LUGRIOT/SmartBees/concentrateur-p4/docs/architecture/ruche-cca-v27-architecture.html

Branche RUCHE-CCA-V27.01 · spec rev 1.1

# Architecture Ruche CCA V27

Un rucher, un concentrateur. Les capteurs Zigbee et le nœud balance parlent au coordinateur XIAO ESP32-C6, qui reste allumé en permanence. L'ESP32-P4 se réveille toutes les 5 minutes, récupère tout, écoute la ruche, puis publie sur le cloud par LTE.

HIVE_ID cca-ruche-0001Zigbee 3.0 · canal 11–26MQTT mTLS :8883cycle 300 s

Vue système

## Qui parle à qui

câble radio trajet d'une pesée

Le réseau Zigbee ne dépend jamais de l'éveil du P4 : le coordinateur garde les reports en mémoire pendant que le P4 dort, puis les lui donne au réveil.

Couches logicielles

## Ce qui tourne sur chaque appareil

### Capteur T/H

appareil du commerce

Firmware fabricantMesure, pile, appairage par appui long

Clusters ZCL standard0x0402 température, 0x0405 humidité, 0x0001 batterie

Zigbee 3.0 · end devicePile CR2450 ou CR2477

à acheter

### Nœud balance

XIAO ESP32-C6 · Arduino

BalanceRuche.inoPesée (4 jetés, moyenne de 10), report à chaque réveil, écoute 5 s, mode réglage 180 s

Adafruit NAU7802I2C 0x2A, gain 128, 10 SPS, LDO 3,0 V, power-down entre deux pesées

Core esp32 3.3.8 · Zigbee ED6 endpoints : poids + 5 réglages, deep sleep

firmware écrit recette au banc Z2M à faire

### Coordinateur

XIAO ESP32-C6 · C

uart_proto · ble_portalLignes JSON vers le P4, file d'écritures vers le nœud balance, BLE avec passkey, impulsion de réveil

zb_interview · report_ring · dev_tableBasic, endpoints, bind, reporting ; anneau de 512 reports

esp-zigbee-lib + ZBOSS · ZCForme le réseau, permit join 1–254 s

spike S3, puis plan 2

### ESP32-P4-NANO

Rust · esp-idf-svc

ruche-fwCycle 5 min, UART C6, I2S, SD, PPP + MQTT, portail Wi-Fi

ruche-coreProtocole C6, converters ZCL façon Zigbee2MQTT, pont, audio, alarme, payloads

ESP-IDF 5.5 + composants Cesp_hosted, esp_modem, usb_host_cdc_acm

ruche-core fait · 41 tests ruche-fw : spikes S1 et S2, puis plan 3

Une mesure, de bout en bout

## Trajet d'une pesée jusqu'au cloud

Exemple réel de format à chaque étape. Le nœud balance pèse la ruche n°1 à 41,853 kg ; le P4 se réveille 122 secondes plus tard.

1. Nœud balancet = 0
  Réveil par son timer (toutes les 3600 s par défaut). 4 échantillons du NAU7802 jetés, moyenne de 10, offset et échelle appliqués. Il envoie le report, attend l'acquittement, écoute 5 s au cas où un réglage l'attend, puis se rendort.

cluster 0x000C Analog Input  attribut 0x0055 PresentValue
type    0x39 float simple     valeur   41.853
2. Coordinateur C6t = 0
  Reçoit le report et le range dans l'anneau avec un numéro de séquence. Rien ne part tant que le P4 ne le demande pas.

anneau[10201] = { ieee 0x00124b0012345678, ep 1, cl 0x000C, at 0x0055, v 41.853, lqi 176 }
3. P4 → C6 par UARTt = 122 s · réveil timer
  Le P4 demande tout ce qui est arrivé depuis le dernier report déjà traité. Le C6 calcule l'âge du report au moment de l'envoi.

→ {"id":3,"cmd":"reports","after":10200,"max":64}
← {"id":3,"seq":10201,"ieee":"0x00124b0012345678","ep":1,"cl":12,"at":85,"ty":57,"v":41.853,"lqi":176,"age_s":122}
← {"id":3,"end":10201,"more":false}
4. ruche-core sur le P4
  c6_proto valide la ligne, bridge date la mesure (maintenant − 122 s), zcl la convertit. Le modèle CCA-RUCHE-WEIGHT fait de la valeur un poids en kg. Bridge::weight_kg retient ce nœud, seul nœud de pesée, et la mesure a moins de 2 h.

weight = 41.85   (arrondi 2 décimales, âge 122 s ≤ 7200 s)
5. MQTT par LTE
  Deux publications : le topic historique de la ruche, avec weight_kg comme en v3, et le topic de l'appareil, façon Zigbee2MQTT.

ruche/cca-ruche-0001/data
  {"hive_id":"cca-ruche-0001","temperature":24.1,"humidity":58,"weight_kg":41.85,"sound_hz":248,"db_level":62.3,…}
ruche/cca-ruche-0001/zigbee/balance_r1
  {"weight":41.85,"battery":92,"linkquality":176,"last_seen":1792540678}
6. Si le réseau LTE manque
  Les deux messages vont dans la file de la carte SD et repartent au cycle suivant, dans l'ordre, les alarmes en premier. Le numéro 10201 n'est marqué traité qu'une fois publié ou écrit sur la SD.

/sdcard/queue/000124.json

Les deux types d'appareils Zigbee

## Nœud balance et capteurs T/H

### Nœud balance · projet ESP32-C6-BalanceRuche

Firmware Arduino écrit à part, avec sa propre spec. Le concentrateur lit son poids comme celui de n'importe quel capteur standard, et lui envoie ses réglages depuis le portail.

Élément | Référence
Carte | Seeed XIAO ESP32-C6, antenne U.FL
Convertisseur | Adafruit NAU7802, 24 bits
Capteur | Variohm AL6N-C3-100kg, 2,0 mV/V, 350 Ω, 6 fils, ≈ 21 475 points/kg
Batterie | Li-Ion 1S, 3,0 à 4,2 V, avec interrupteur

### Endpoints Zigbee

EP | Cluster | Rôle
1 | Analog Input 0x000C | weight en kg, reporté
1 | Power Config 0x0001 | batterie %, reportée
1 | Basic 0x0000 | modèle CCA-RUCHE-WEIGHT, nom en 0x0010
2 | Analog Output 0x000D | tare (écriture)
3 | Analog Output | calibration_kg, masse connue > 0
4 | Analog Output | interval_s, 60 à 86 400 s
5 | Analog Output | offset, zéro brut
6 | Analog Output | scale, points par kg, ≥ 1000

### Câblage

Liaison | Raccordement
NAU7802 SDA / SCL | D4 (GPIO22) / D5 (GPIO23)
NAU7802 VIN / GND | 3V3 / GND du XIAO
AL6N, 6 fils | E+ et Sense+ → E+ ; E− et Sense− → E− ; S+ → A+ ; S− → A− ; blindage à GND côté carte
Batterie + | interrupteur, puis pastille BAT+
Batterie − | pastille BAT−
Mesure batterie | pont 200 kΩ / 200 kΩ vers A0 (GPIO0), 100 nF

### Comportement

- Cycle normal : réveil toutes les interval_s (3600 s par défaut), environ 4 s d'éveil, puis 5 s d'écoute des réglages.
- Interrupteur sur marche : mode réglage de 180 s, avec une pesée toutes les 10 s. C'est le moment d'appairer, de tarer et d'étalonner.
- Interrupteur sur arrêt : le nœud est hors tension et la batterie ne se décharge pas, mais l'USB-C ne la recharge plus. Le remettre sur marche avant de recharger.
- Batterie sous 3,30 V : la radio n'est pas démarrée et le nœud se rendort.
- Appui de 10 s sur BOOT : le nœud quitte le réseau ; tare et étalonnage restent en mémoire.
- Autonomie estimée : 8 à 9 mois par 1000 mAh à 3600 s.

### Réglages depuis le portail

Le nœud n'écoute que pendant ses quelques secondes d'éveil. Le coordinateur garde donc chaque réglage en file et le lui envoie dès qu'il reçoit sa pesée suivante.

POST /api/zigbee/devices/0x…5678/set  {"tare":true}
← {"queued":["tare"]}
… au réveil suivant du nœud …
C6 → P4  {"ev":"write_done","ieee":"0x…5678","ep":2,"cl":13,"at":85,"ok":true}

### Capteurs température / humidité

Tout capteur qui respecte les clusters ZCL standard fonctionne sans code supplémentaire. Ceux qui passent par le cluster propriétaire Tuya 0xEF00 ne sont pas pris en charge en V27.

Modèle | Clusters | V27
Sonoff SNZB-02P / 02D | T, HR, batterie | oui
Aqara WSDCGQ11LM | T, HR, pression | oui
Tuya TS0201 | T, HR (standard) | oui
Tuya TS0601 | 0xEF00 | non

### Reporting configuré par le coordinateur

Mesure | min / max | Seuil
Température 0x0402 | 60 s / 900 s | Δ 0,2 °C
Humidité 0x0405 | 60 s / 900 s | Δ 1 %
Batterie 0x0001 | 60 s / 3600 s | —

### Appairage depuis le portail

- Onglet Zigbee, « Ouvrir l'inclusion 180 s ».
- Appui long sur le bouton du capteur jusqu'au clignotement.
- Le capteur apparaît sous son adresse IEEE ; le renommer, par exemple th_couvain_r1.

ruche/cca-ruche-0001/zigbee/th_couvain_r1
  {"temperature":34.6,"humidity":61.2,"battery":87,"voltage":2950,"linkquality":176,"last_seen":1792540678}

Un capteur placé dans la ruche, au-dessus du couvain, doit lire environ 34 à 35 °C. Un capteur sous le plateau donne l'ambiance du rucher.

Ce qui arrive sur le cloud

## Topics MQTT

Topic | Contenu | QoS
ruche/<id>/data | Synthèse de la ruche : champs v3, dont weight_kg, plus audio et état Zigbee | 0
ruche/<id>/zigbee/<nom> | Dernières valeurs d'un appareil Zigbee | 0
ruche/<id>/alarm | Alarme acoustique : raised, active, cleared | 1
ruche/<id>/bridge/state | Santé du concentrateur, versions, erreurs, file SD (retained) | 0
ruche/<id>/bridge/devices | Liste des appareils appairés (retained) | 1
ruche/<id>/bridge/event | Appareil arrivé, parti, interview échouée | 0
