LUGRIOT/SmartBees/concentrateur-p4/modem_usb_power_switch.png

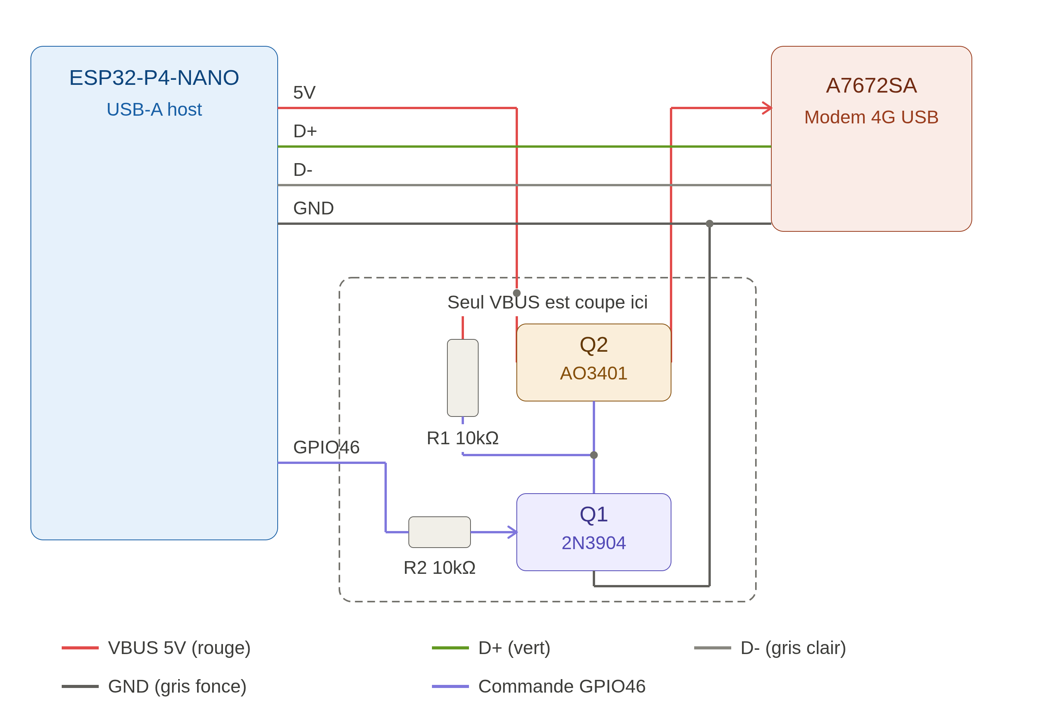
concentrateur-p4/modem_usb_power_switch.png
