LUGRIOT/SmartBees/(commit log)

2026-11-03 SmartBees : concentrateur V27 (ESP32-P4) et balance Zigbee (XIAO ESP32-C6)
2026-11-03 chore: CI GitHub Actions et guide de contribution
    - CI : fmt, clippy -D warnings et tests de ruche-core (Rust 1.94.1),
    tests scale_math et controles statiques du sketch balance
    - CONTRIBUTING.md : flux fork/PR, tests, regles du code, ajout d'un
    appareil Zigbee, secrets
